Shved812/Coursework_LogicAnalyzer/Анализатор ЦУиМП.pptx

## Курсовая работа по дисциплине «Цифровые устройства и микропроцессоры» на тему «Алгоритмы шифрования в цифровом логическом анализаторе на базе ПЛИС»

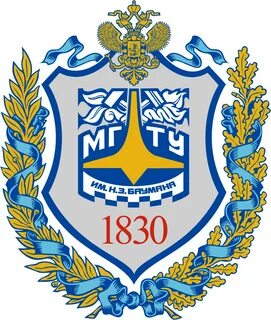
[picture p1: figure]

Подготовил студент
МГТУ им. Н. Э. Баумана
Группы РЛ6-71
Омаров Д.В.

## Предмет разработки

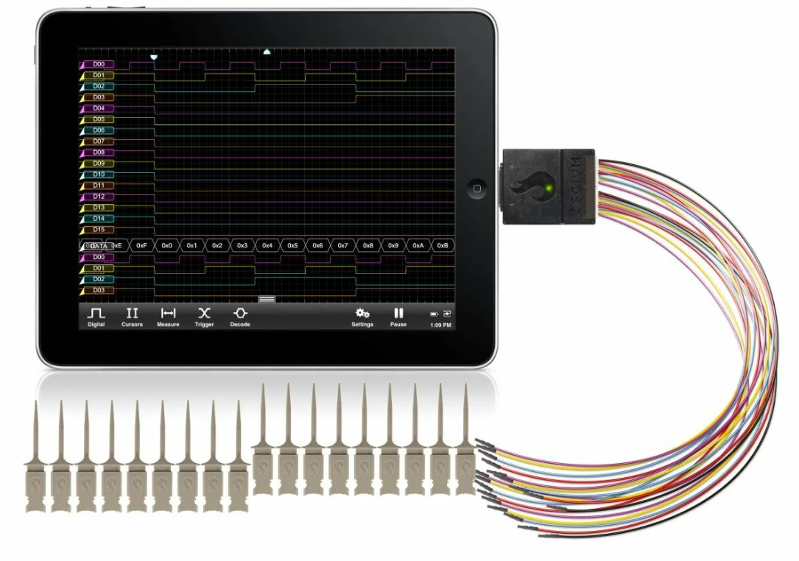
[picture p2: figure]

- Предметом разработки данной работы является разработка и применение алгоритмов сжатия данных в архитектуре цифрового анализатора логических сигналов

## Назначение устройства

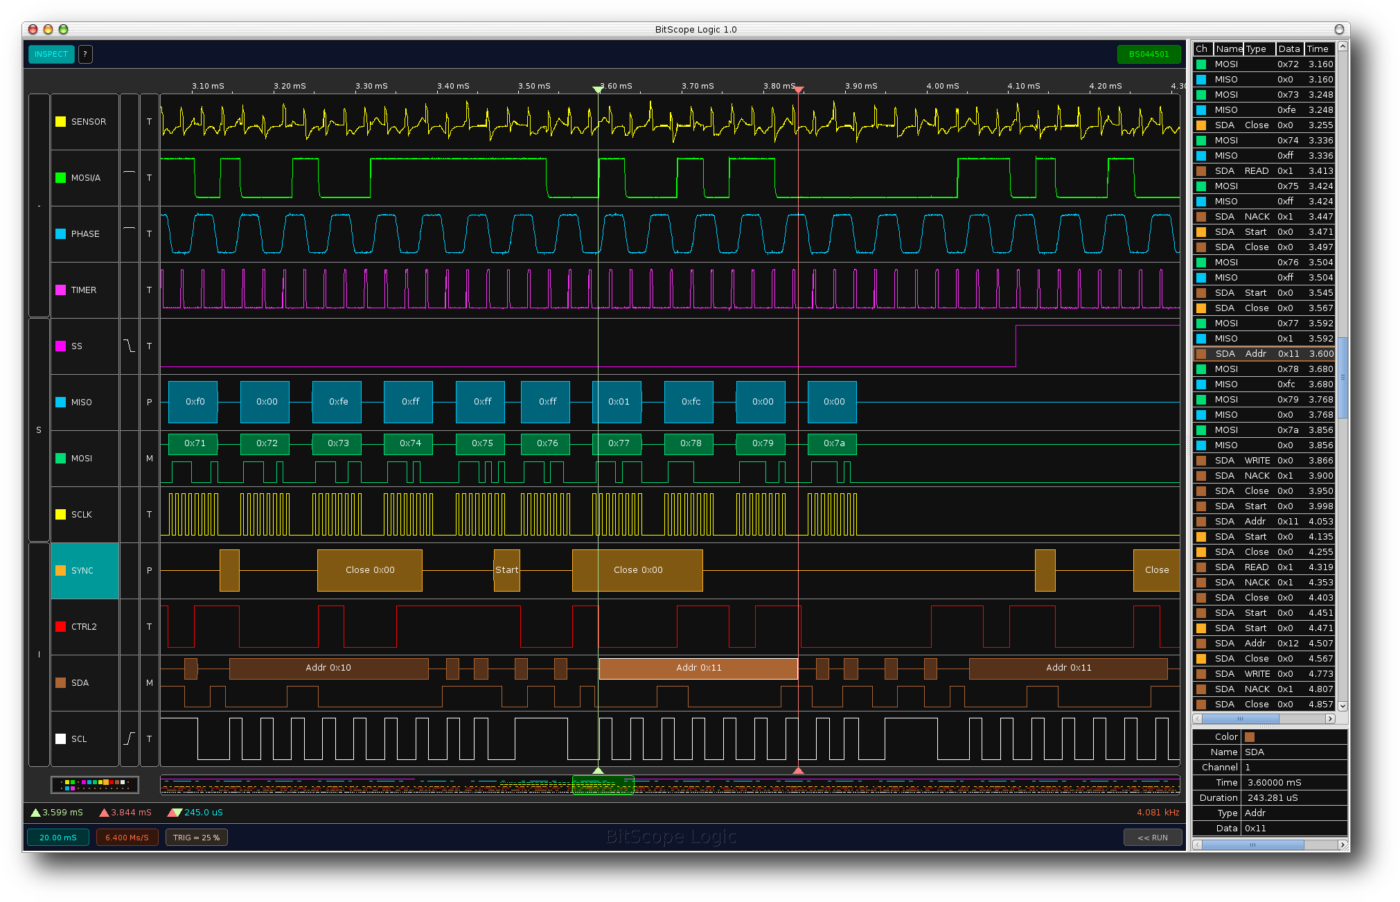
[picture p3: figure]

- Анализатор логических сигналов применяется для анализа и предоставления временных диаграмм логических сигналов

## Области применения

- Устройства широко применяется для отладки и настройки цифровой аппаратуры ASIC, SoC, FPGA
- Логический анализатор также может применятся для автоматического анализа сигналов в случаях когда прямое взаимодействие с пользователем невозможно: спутниковые системы, бортовая аппаратура, лаборатории

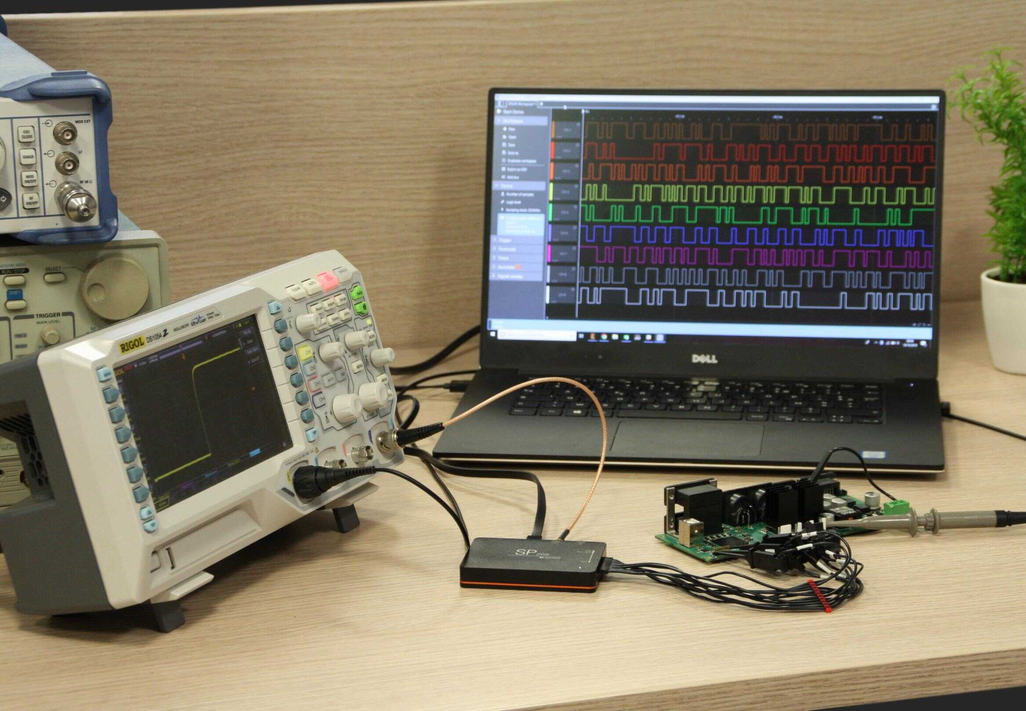
[picture p4: figure]

## Пример реализации Salae Logic 8

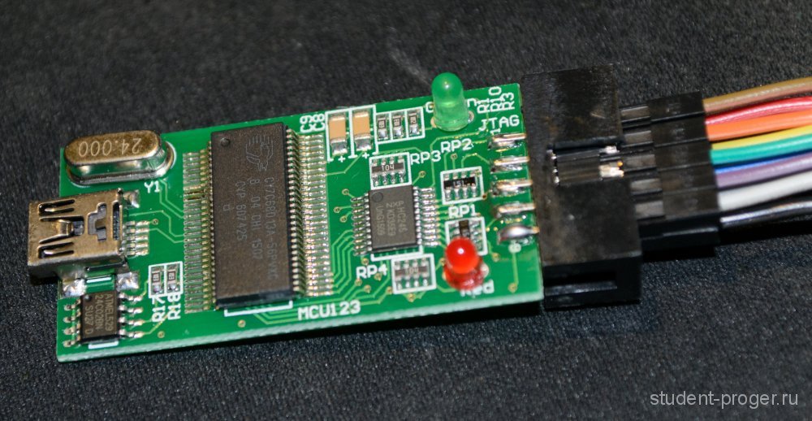
[picture p5: figure]

## Функциональная схема устройства

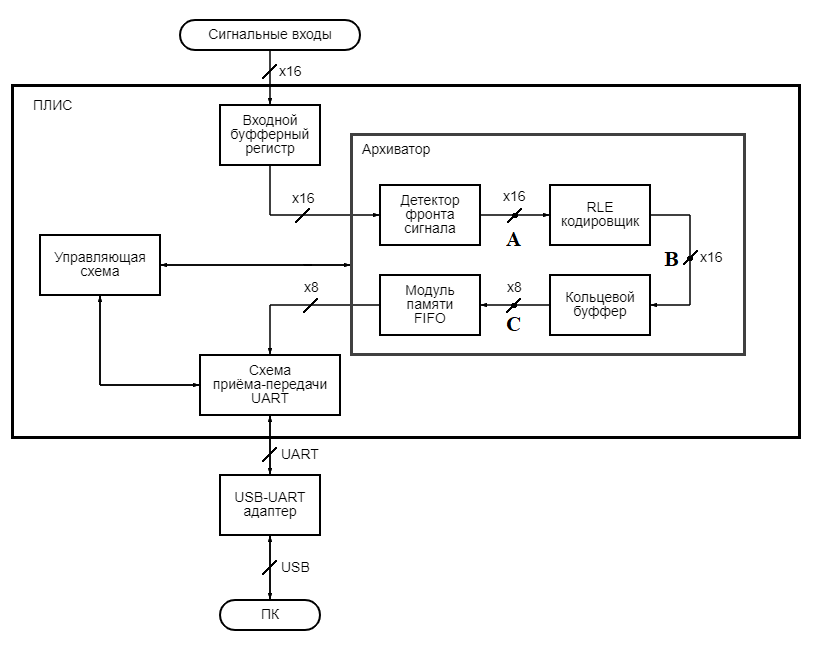
[picture p6: figure]

## Работа отдельных блоков устройства

## Работа модуля приёмника UART

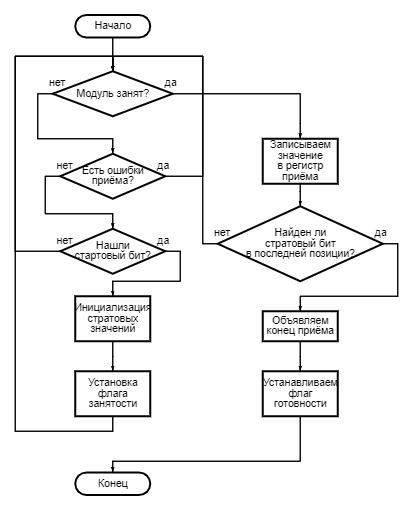
[picture p7: figure]

- Регистр данных
- Схема занесения сигналов в регистр данных
- Счётчик тактовых сигналов
- Обработка ошибки
- Обработка конца передачи

## Проблема синхронизации UART

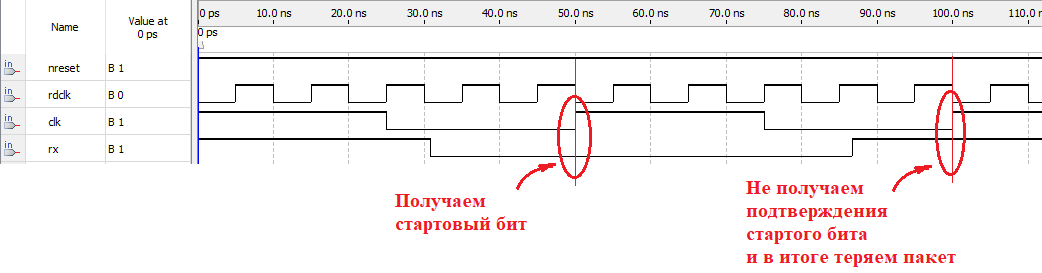
[picture p8: figure]
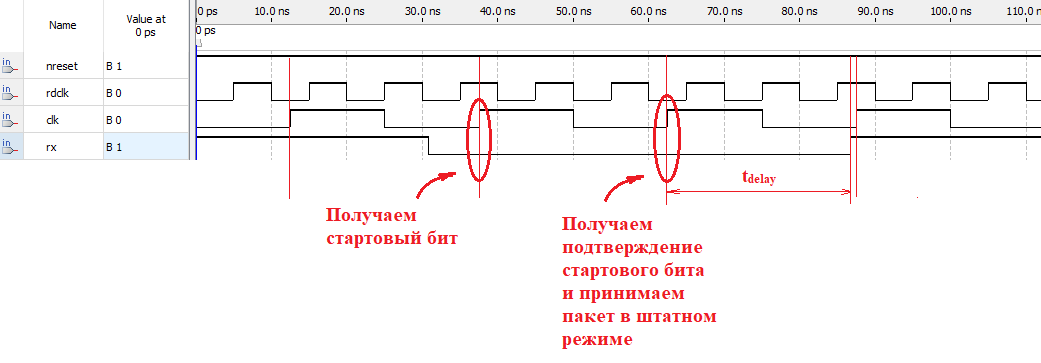
[picture p9: figure]

## Временная диаграмма приёмника UART

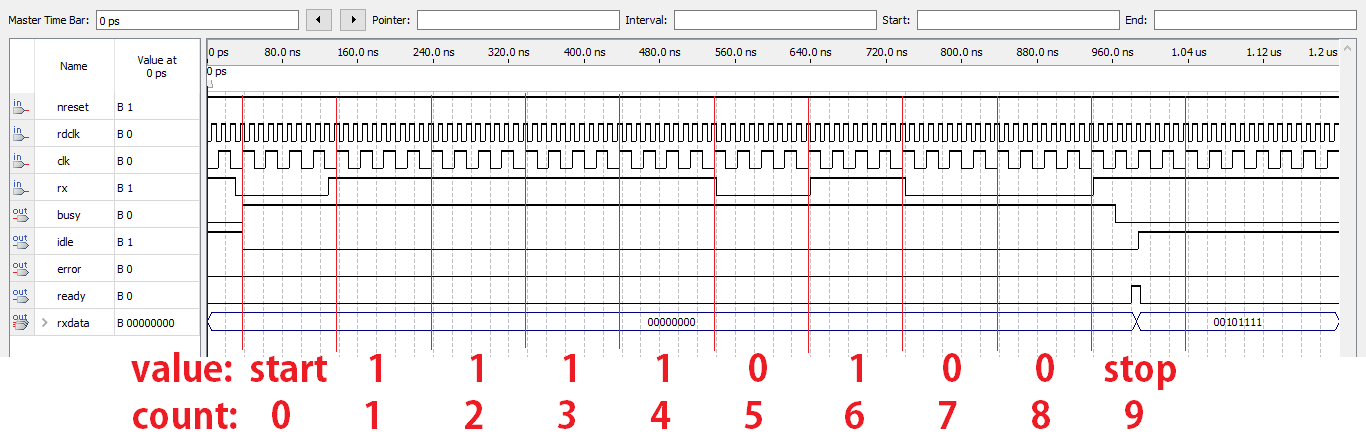
[picture p10: figure]

## Работа передатчика UART

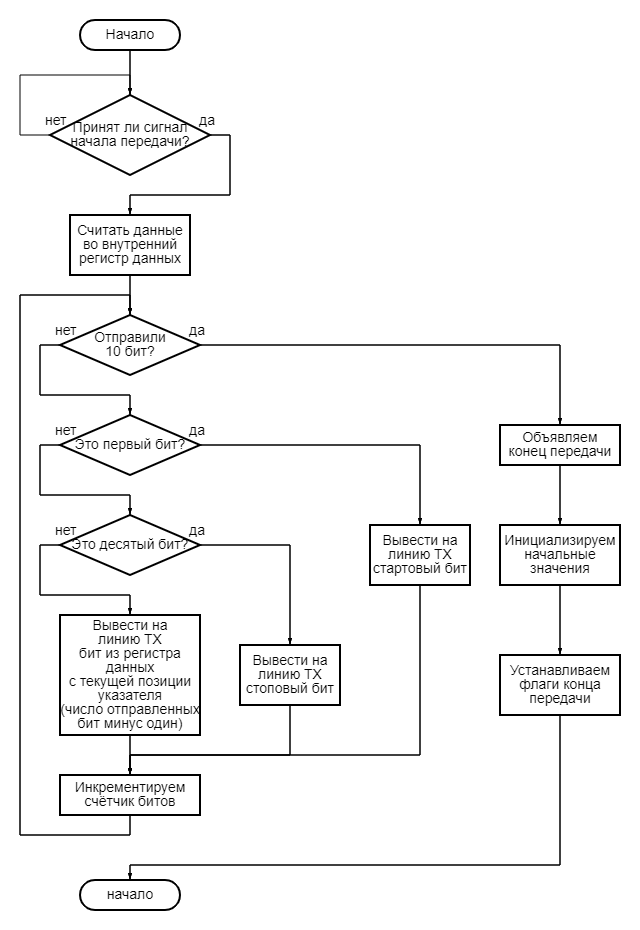
[picture p11: figure]

- Регистр данных
- Счётчик отправленных данных
- Счётчик тактовых сигналов
- Схема инициализации начальных и конечных состояний регистров

## Временная диаграмма передатчика UART

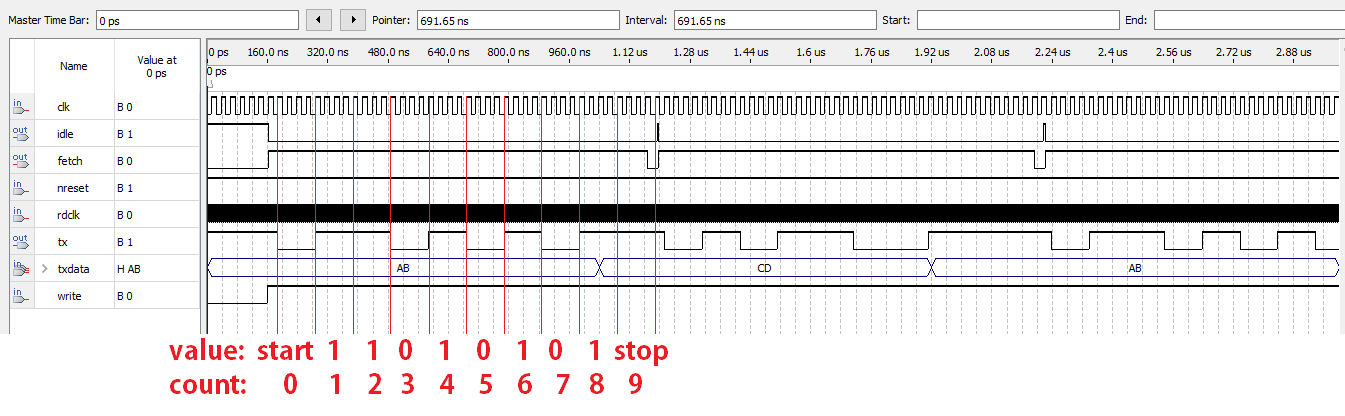
[picture p12: figure]

## Работа детектора фронта

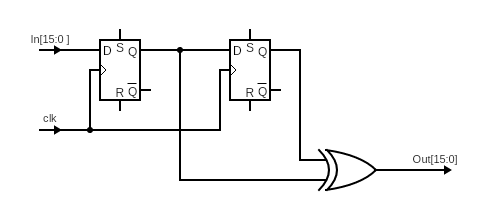
[picture p13: figure]

## Временная диаграмма детектора фронта

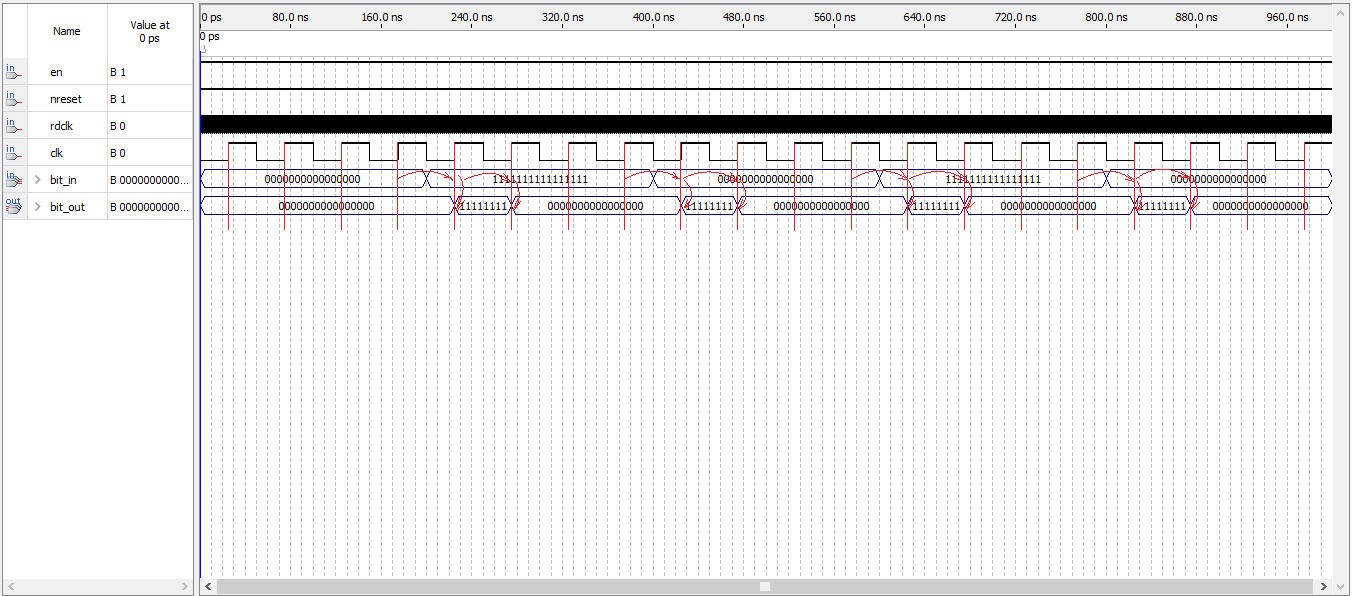
[picture p14: figure]

## RLE метод кодирования

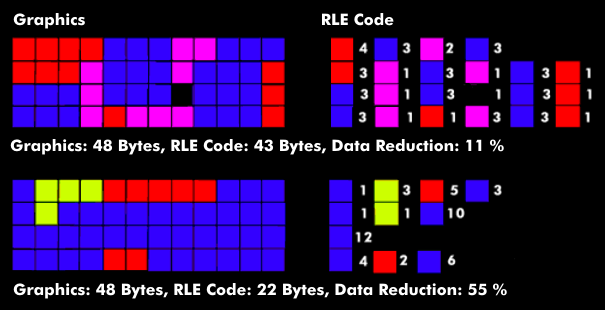
[picture p15: figure]

## Проблемы стандартного RLE алгоритма

- Стандартный метод на часто меняющихся данных вместо сжатия производит расширение данных:
По стандартному методу в случае данных вида ‘101’[b] будет отправлять три отдельные 16-ти битные команды вместо 3-х битов
Т.е. произойдёт увеличение данных на
1500% (16 раз)
- Тогда будет эффективнее в таких случаях вообще не сжимать данные
В таком случае ввиду формата команды данные увеличатся на
45% (1,5 раз)
Очевидно такой метод эффективнее примерно в 10,5 раз на быстро меняющихся данных

## Модуль кодирования: параметры кода

Формат кода:
  - Командный – 1 бит
  - Адрес порта – 4 бита
  - Значение – 11 бит
Метод кодирования:
  - Comm_bit = ‘0’ : RLE кодирование
  - Comm_bit = ‘1’ : Оригинал

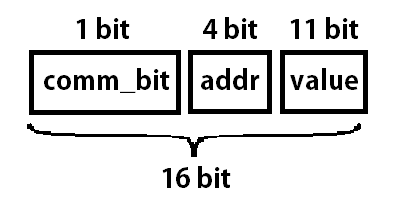
[picture p16: figure]

## Временная диаграмма унарного кодировщика

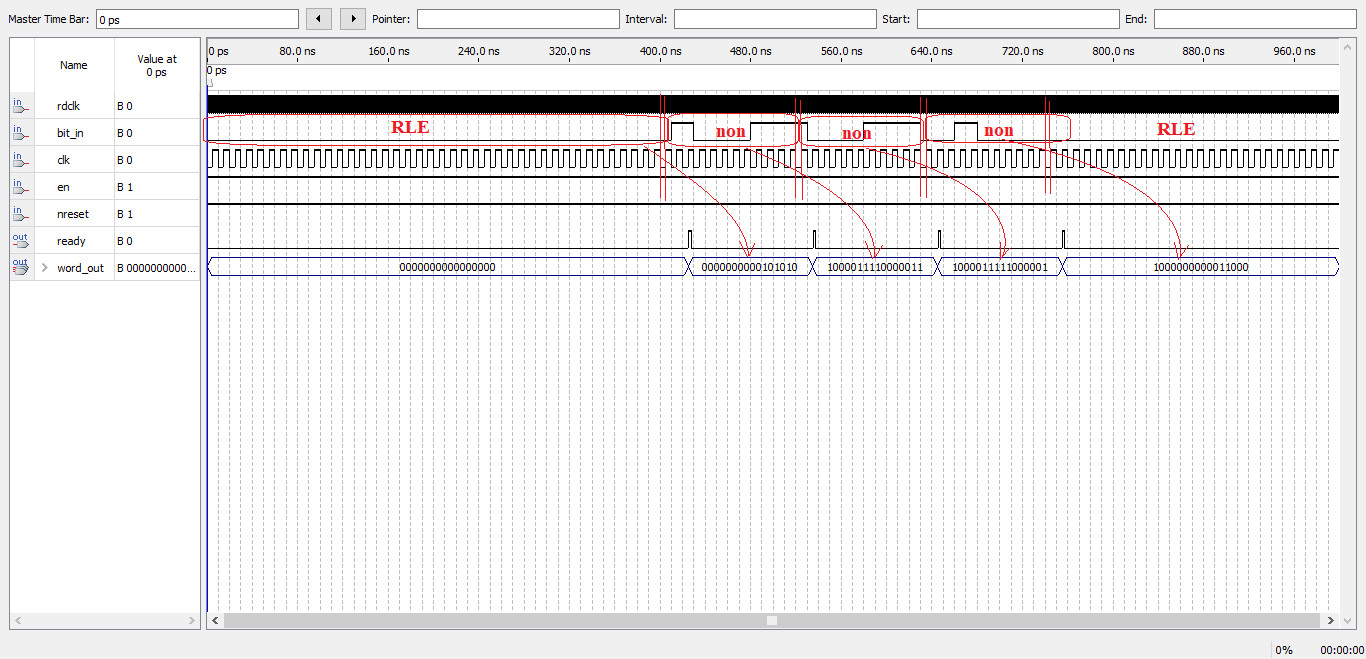
[picture p17: figure]

## Временная диаграмма полного кодировщика (1)

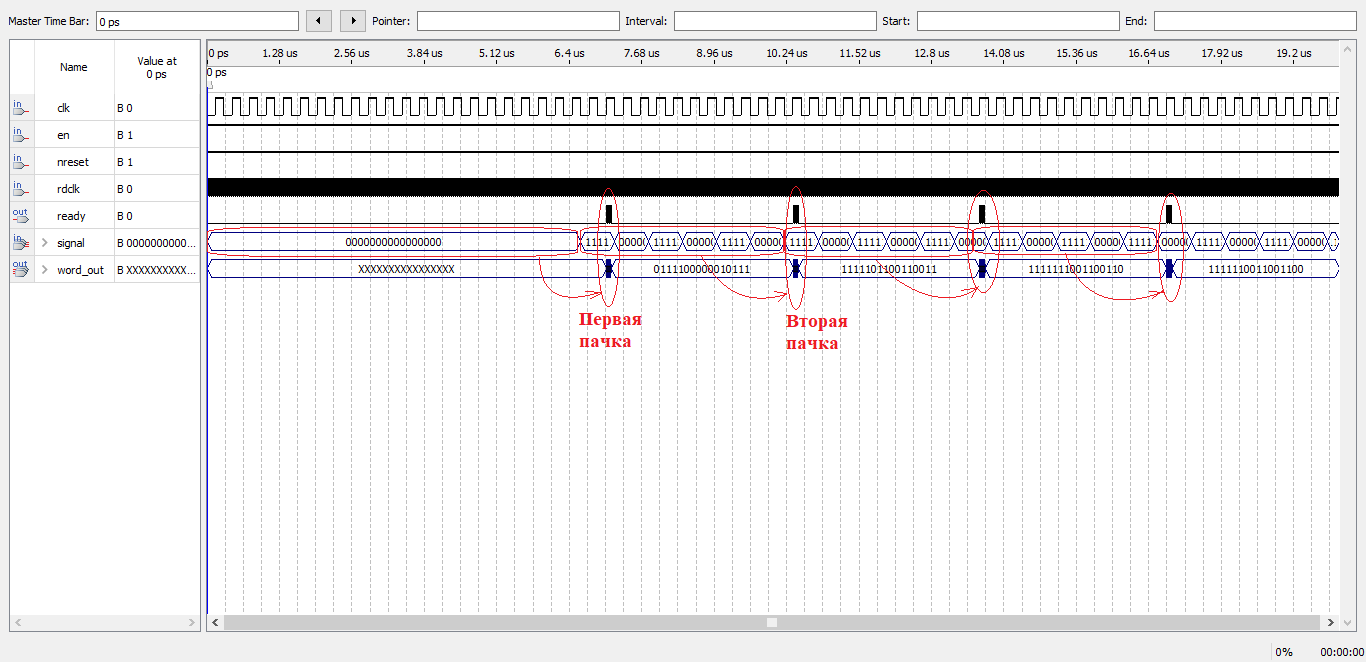
[picture p18: figure]

## Временная диаграмма полного кодировщика (2)

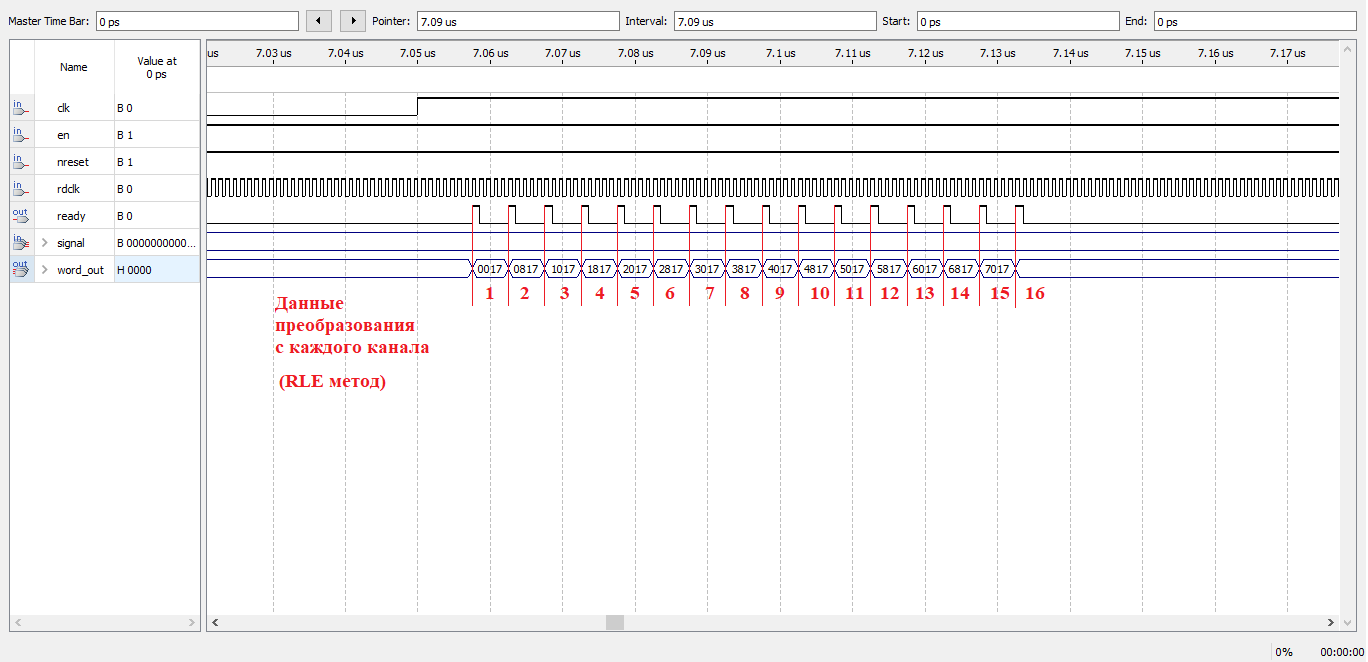
[picture p19: figure]

## Временная диаграмма полного кодировщика (3)

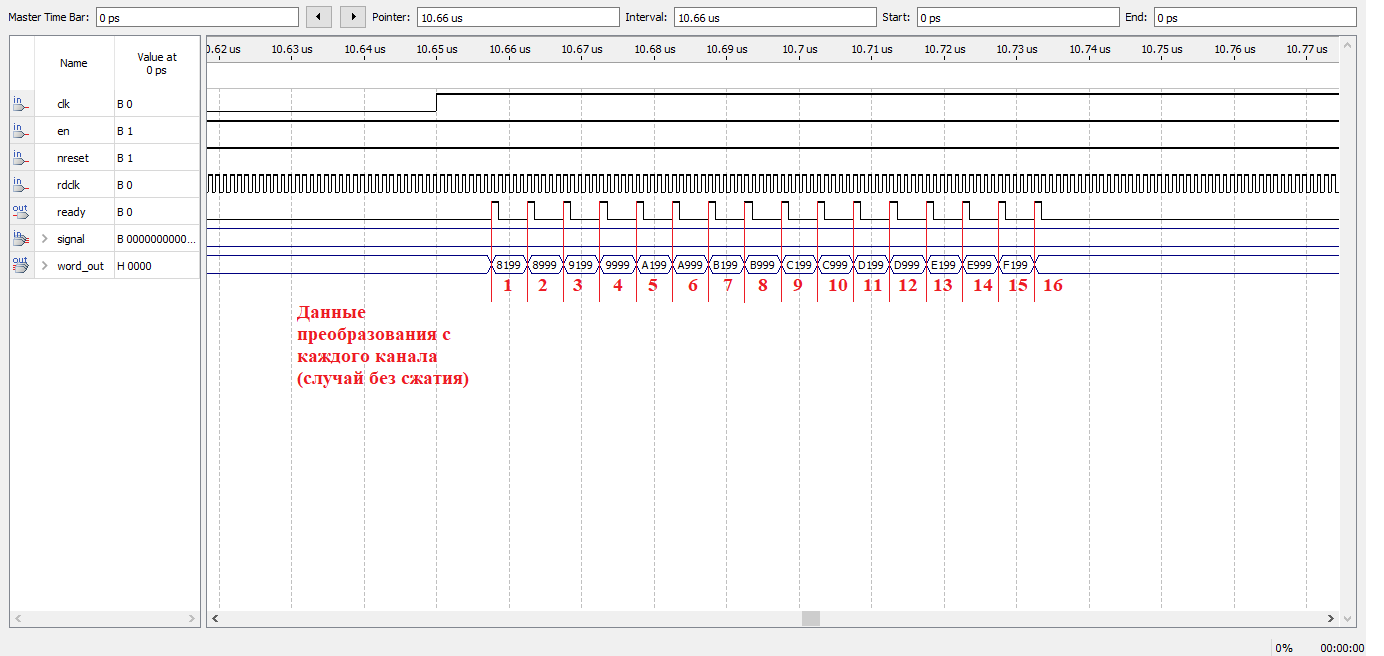
[picture p20: figure]

## Кольцевой буфер

- Реализован по методу двух указателей
- Считывание данных в буфер производиться 2 байтовыми словами с инкрементацией указателя начала на две позиции
- Данные хранятся побайтно
- Считывание данных в буфер производиться побайтно с инкрементацией указателя конца на одну позицию

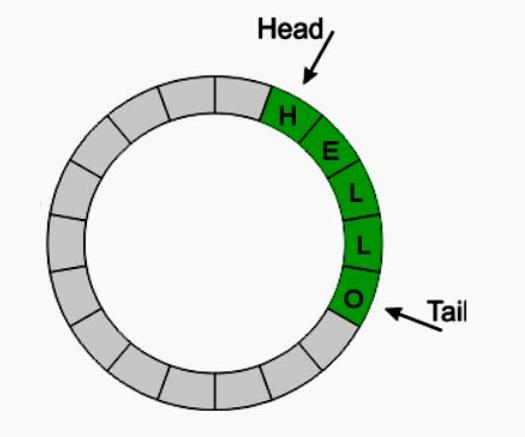
[picture p21: figure]

## Временная диаграмма кольцевого буфера

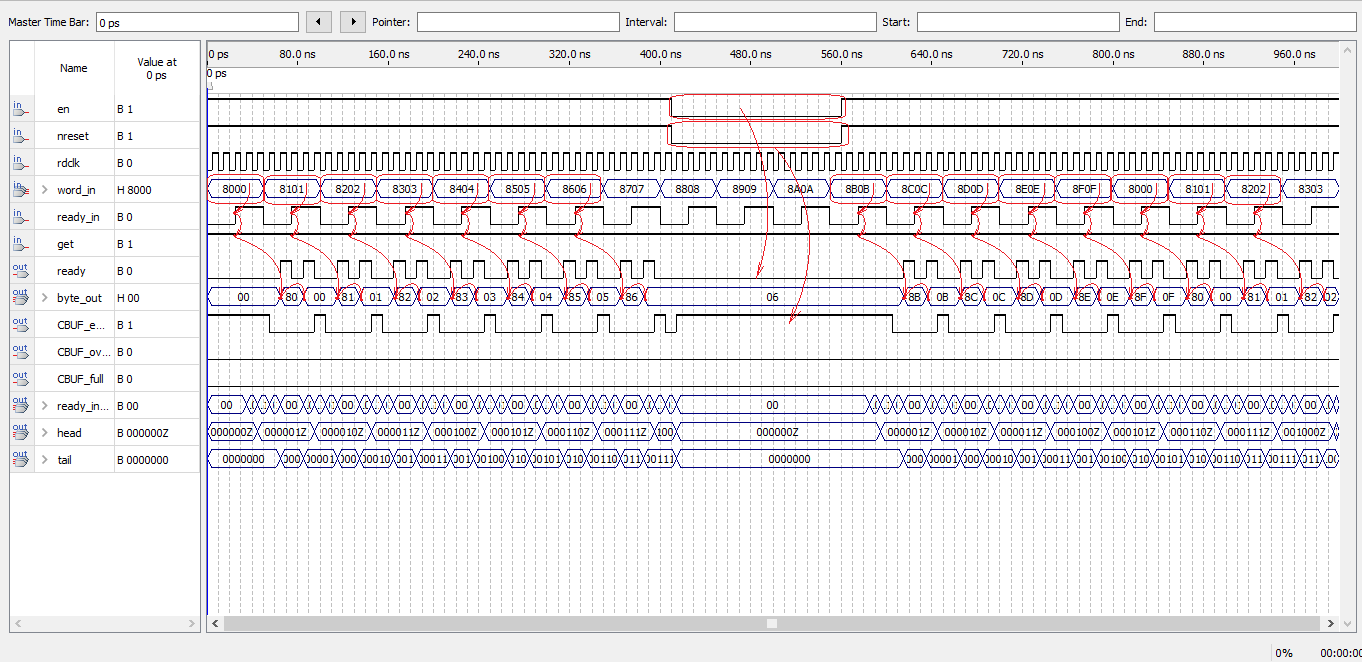
[picture p22: figure]

## Модуль встроенной FIFO памяти

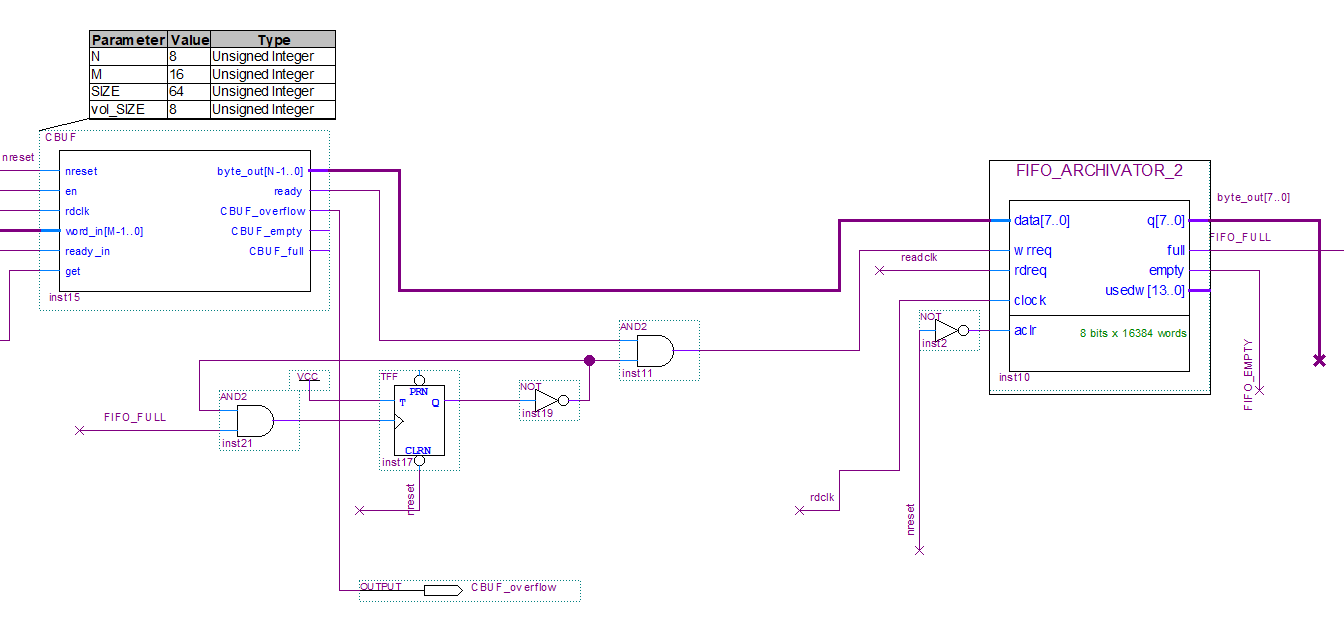
[picture p23: figure]

## Программа для ПК

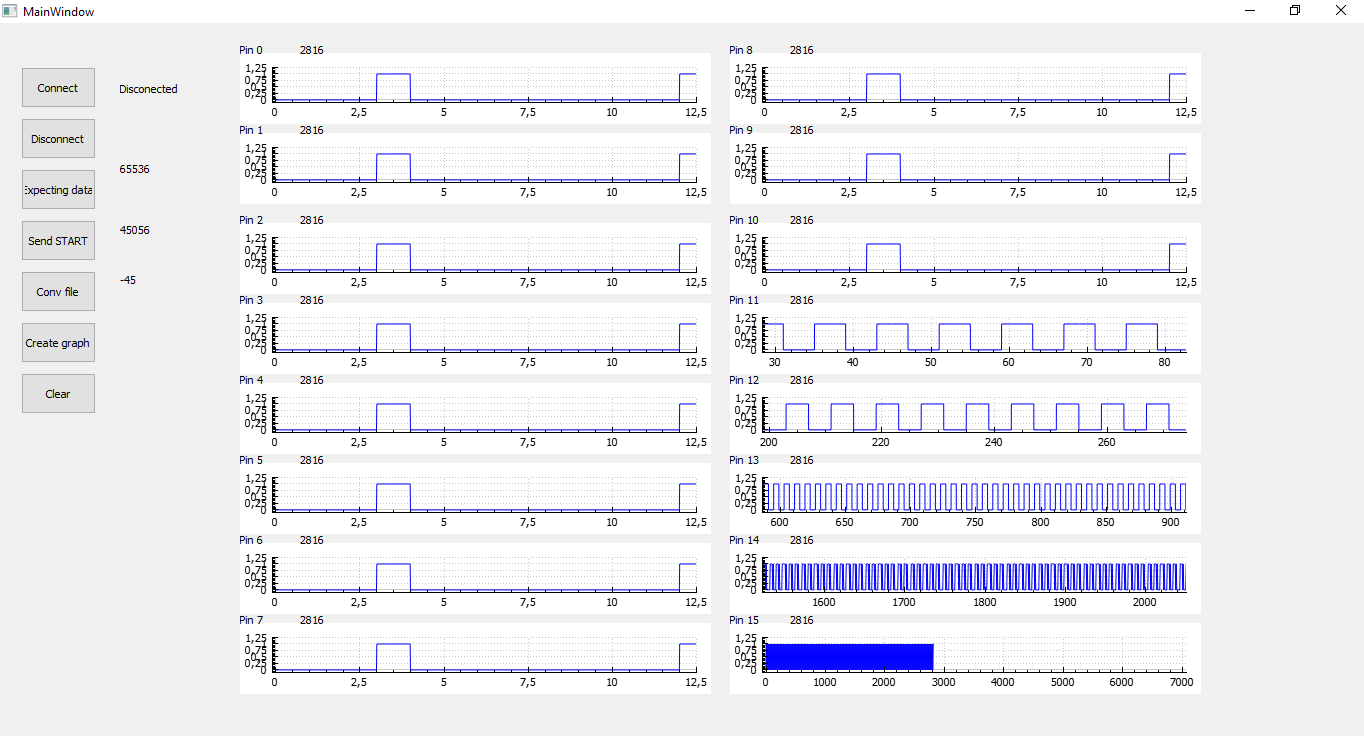
[picture p24: figure]

## Результаты исследований степени сжатия

Обозначения:
N_(compr) – Число отсчётов сжатой последовательности;
N – Число отсчётов несжатой последовательности;
θ – Степень сжатия:

θ=(N−N_(compr))/N⋅100%

## Результаты исследований степени сжатия

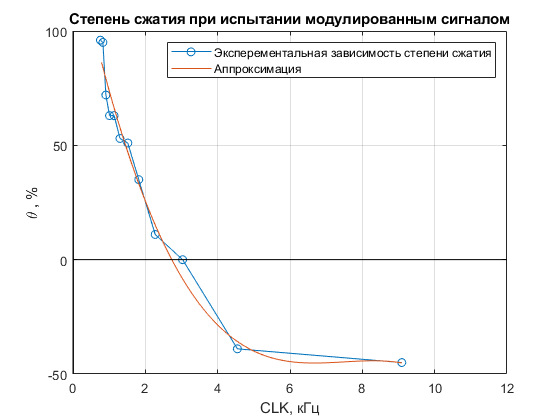
[picture p25: figure]
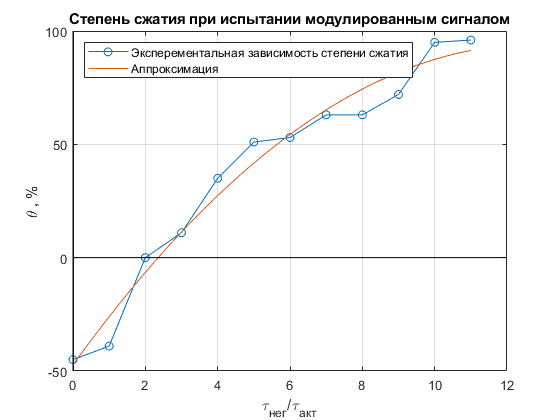
[picture p26: figure]

## Результаты исследований степени сжатия

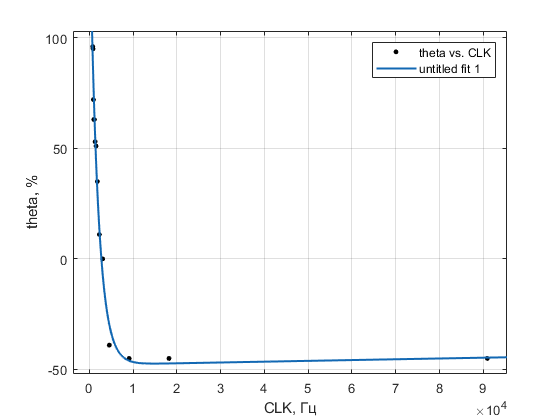
[picture p27: figure]

- Двух экспоненциальная аппроксимация результатов исследования

θ(f, Гц)=209,1exp(−5,395⋅10^(−4) ⋅ f)−
−47,97exp(−7,893⋅10^(−7) ⋅f), [%]
