Shved812/Coursework_LogicAnalyzer/(list of files, cad)

Other CAD files:
Quartus project/simulation/qsim/work/@a@r@c@h@i@v@a@t@o@r_testbench/verilog.psm
Quartus project/simulation/qsim/work/@a@r@c@h@i@v@a@t@o@r_testbench_vlg_check_tst/verilog.psm
Quartus project/simulation/qsim/work/@a@r@c@h@i@v@a@t@o@r_testbench_vlg_sample_tst/verilog.psm
Quartus project/simulation/qsim/work/@a@r@c@h@i@v@a@t@o@r_testbench_vlg_vec_tst/verilog.psm
Quartus project/simulation/qsim/work/@a@r@c@h@i@v@a@t@o@r_vlg_check_tst/verilog.psm
Quartus project/simulation/qsim/work/@a@r@c@h@i@v@a@t@o@r_vlg_sample_tst/verilog.psm
Quartus project/simulation/qsim/work/@a@r@c@h@i@v@a@t@o@r_vlg_vec_tst/verilog.psm
Quartus project/simulation/qsim/work/@c@o@t@r@o@l_@c@i@r@c@u@i@t/verilog.psm
Quartus project/simulation/qsim/work/@c@o@t@r@o@l_@c@i@r@c@u@i@t_vlg_check_tst/verilog.psm
Quartus project/simulation/qsim/work/@c@o@t@r@o@l_@c@i@r@c@u@i@t_vlg_sample_tst/verilog.psm
Quartus project/simulation/qsim/work/@c@o@t@r@o@l_@c@i@r@c@u@i@t_vlg_vec_tst/verilog.psm
Quartus project/simulation/qsim/work/@e@d@g@e_@c@o@d@e@r/verilog.psm
Quartus project/simulation/qsim/work/@e@d@g@e_@c@o@d@e@r_vlg_check_tst/verilog.psm
Quartus project/simulation/qsim/work/@e@d@g@e_@c@o@d@e@r_vlg_sample_tst/verilog.psm
Quartus project/simulation/qsim/work/@e@d@g@e_@c@o@d@e@r_vlg_vec_tst/verilog.psm
Quartus project/simulation/qsim/work/counter_locked/verilog.psm
Quartus project/simulation/qsim/work/counter_locked_vlg_check_tst/verilog.psm
Quartus project/simulation/qsim/work/counter_locked_vlg_sample_tst/verilog.psm
Quartus project/simulation/qsim/work/counter_locked_vlg_vec_tst/verilog.psm
Quartus project/simulation/qsim/work/modulator/verilog.psm
Quartus project/simulation/qsim/work/modulator_vlg_check_tst/verilog.psm
Quartus project/simulation/qsim/work/modulator_vlg_sample_tst/verilog.psm
Quartus project/simulation/qsim/work/modulator_vlg_vec_tst/verilog.psm
Quartus project/simulation/qsim/work/parallelizer/verilog.psm
Quartus project/simulation/qsim/work/parallelizer_vlg_check_tst/verilog.psm
Quartus project/simulation/qsim/work/parallelizer_vlg_sample_tst/verilog.psm
Quartus project/simulation/qsim/work/parallelizer_vlg_vec_tst/verilog.psm
Quartus project/simulation/qsim/work/sender_counter/verilog.psm
Quartus project/simulation/qsim/work/sender_counter_vlg_check_tst/verilog.psm
Quartus project/simulation/qsim/work/sender_counter_vlg_sample_tst/verilog.psm
Quartus project/simulation/qsim/work/sender_counter_vlg_vec_tst/verilog.psm
Quartus project/simulation/qsim/work/valider/verilog.psm
Quartus project/simulation/qsim/work/valider_vlg_check_tst/verilog.psm
Quartus project/simulation/qsim/work/valider_vlg_sample_tst/verilog.psm
Quartus project/simulation/qsim/work/valider_vlg_vec_tst/verilog.psm
