Shved812/Coursework_LogicAnalyzer/QT program project/COM_project_2/mainwindow.h

#ifndef MAINWINDOW_H
#define MAINWINDOW_H

#include <QMainWindow>
#include <QThread>
#include <QCloseEvent>
#include <QMessageBox>
#include "object_sread.h"
#include "COMp_WinAPI.h"


QT_BEGIN_NAMESPACE
namespace Ui { class MainWindow; }
QT_END_NAMESPACE

class MainWindow : public QMainWindow
{
    Q_OBJECT

public:
    MainWindow(QWidget *parent = nullptr);
    ~MainWindow();

private slots:
    void on_pushButton_clicked();

    void on_pushButton_2_clicked();

    void on_pushButton_3_clicked();

    void on_pushButton_4_clicked();

    void on_pushButton_5_clicked();

    void on_pushButton_6_clicked();

    void on_pushButton_7_clicked();

private:
    Ui::MainWindow *ui;
    QThread thread_1;
    Object_sread Object_sread_1;
    void closeEvent(QCloseEvent *event);
};
#endif // MAINWINDOW_H
