Shved812/Coursework_LogicAnalyzer/Quartus project/simulation/qsim/work/@a@r@c@h@i@v@a@t@o@r_testbench_vlg_sample_tst/_primary.vhd

library verilog;
use verilog.vl_types.all;
entity ARCHIVATOR_testbench_vlg_sample_tst is
    port(
        bit_in          : in     vl_logic_vector(15 downto 0);
        clk             : in     vl_logic;
        clock2          : in     vl_logic;
        data2           : in     vl_logic_vector(7 downto 0);
        en              : in     vl_logic;
        nreset          : in     vl_logic;
        rdclk           : in     vl_logic;
        rdreq2          : in     vl_logic;
        read            : in     vl_logic;
        readclk         : in     vl_logic;
        sclr2           : in     vl_logic;
        wrreq1          : in     vl_logic;
        sampler_tx      : out    vl_logic
    );
end ARCHIVATOR_testbench_vlg_sample_tst;
