Shved812/Coursework_LogicAnalyzer/Quartus project/simulation/qsim/work/modulator_vlg_sample_tst/_primary.vhd

library verilog;
use verilog.vl_types.all;
entity modulator_vlg_sample_tst is
    port(
        clk             : in     vl_logic;
        en              : in     vl_logic;
        nreset          : in     vl_logic;
        sampler_tx      : out    vl_logic
    );
end modulator_vlg_sample_tst;
