Shved812/Coursework_LogicAnalyzer/Quartus project/simulation/qsim/work/parallelizer/_primary.vhd

library verilog;
use verilog.vl_types.all;
entity parallelizer is
    port(
        \in\            : in     vl_logic;
        \out\           : out    vl_logic_vector(15 downto 0)
    );
end parallelizer;
